TBAMax/WidebandLambda/README.md

# WidebandLambda

LSU4.9 conrtoller hardware based on Arduino Nano and Bosch CJ125 chip.
Has standard 18x2 character LCD display.
Can be used as standalone lambda monitor or as lambda controller for Speeduino.
Originally designed to be used with Speeduino.
