TBAMax/WidebandLambda/KiCad_drawings/TeemoWB1.1/ParandusedLog.odt

- Heaterile flyback diood, kuna võib olla induktiivne koormus. tehtud. Täpsustada:Schottky diood
- Aku pinge lugemise pingejagur Arduino A2 sisendile.Tehtud
- Lisada silukondekas VREFpinile? Kas kasutab seda? Või võtab aluseks toite5V?ei kasuta
- D8 D9 vahetatud. Tehtud
- teha:lisada analog väljund RCfilter pin 9 peale(timer1 väljund)
- Kütte väljund paigutada hoopis D3 pinile. Tehtud.
- ja sealt siis LCD_D6 paigutada A1-le. Tehtud
- edaspidi inglisekeelses failis
