TBAMax/WidebandLambda/KiCad_drawings/TeemoWB1.1/TeemoWB.pdf

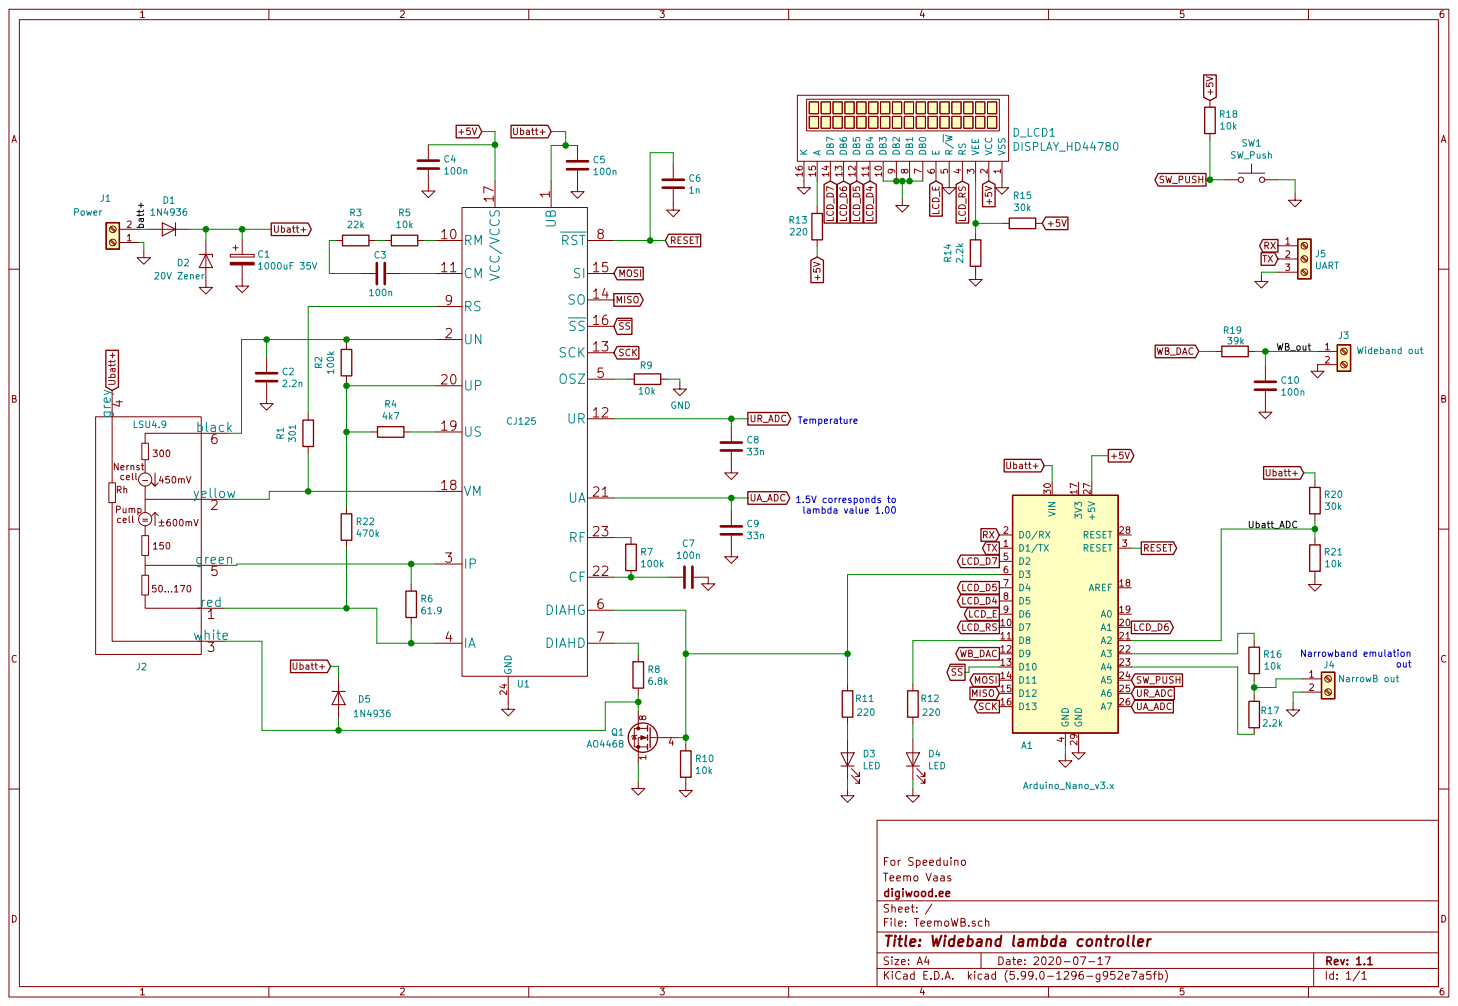
[picture p1: page 1]

Id: 1/1 Title: Wideband lambda controller File: TeemoWB.sch Sheet: / digiwood.ee Teemo Vaas For SpeeduinoR14 2.2k R7
