TBAMax/WidebandLambda/KiCad_drawings/TeemoWB1.1/TeemoWB.kicad_pcb

## KiCad design KiCad_drawings/TeemoWB1.1/TeemoWB.kicad_pcb (2020-08-08)

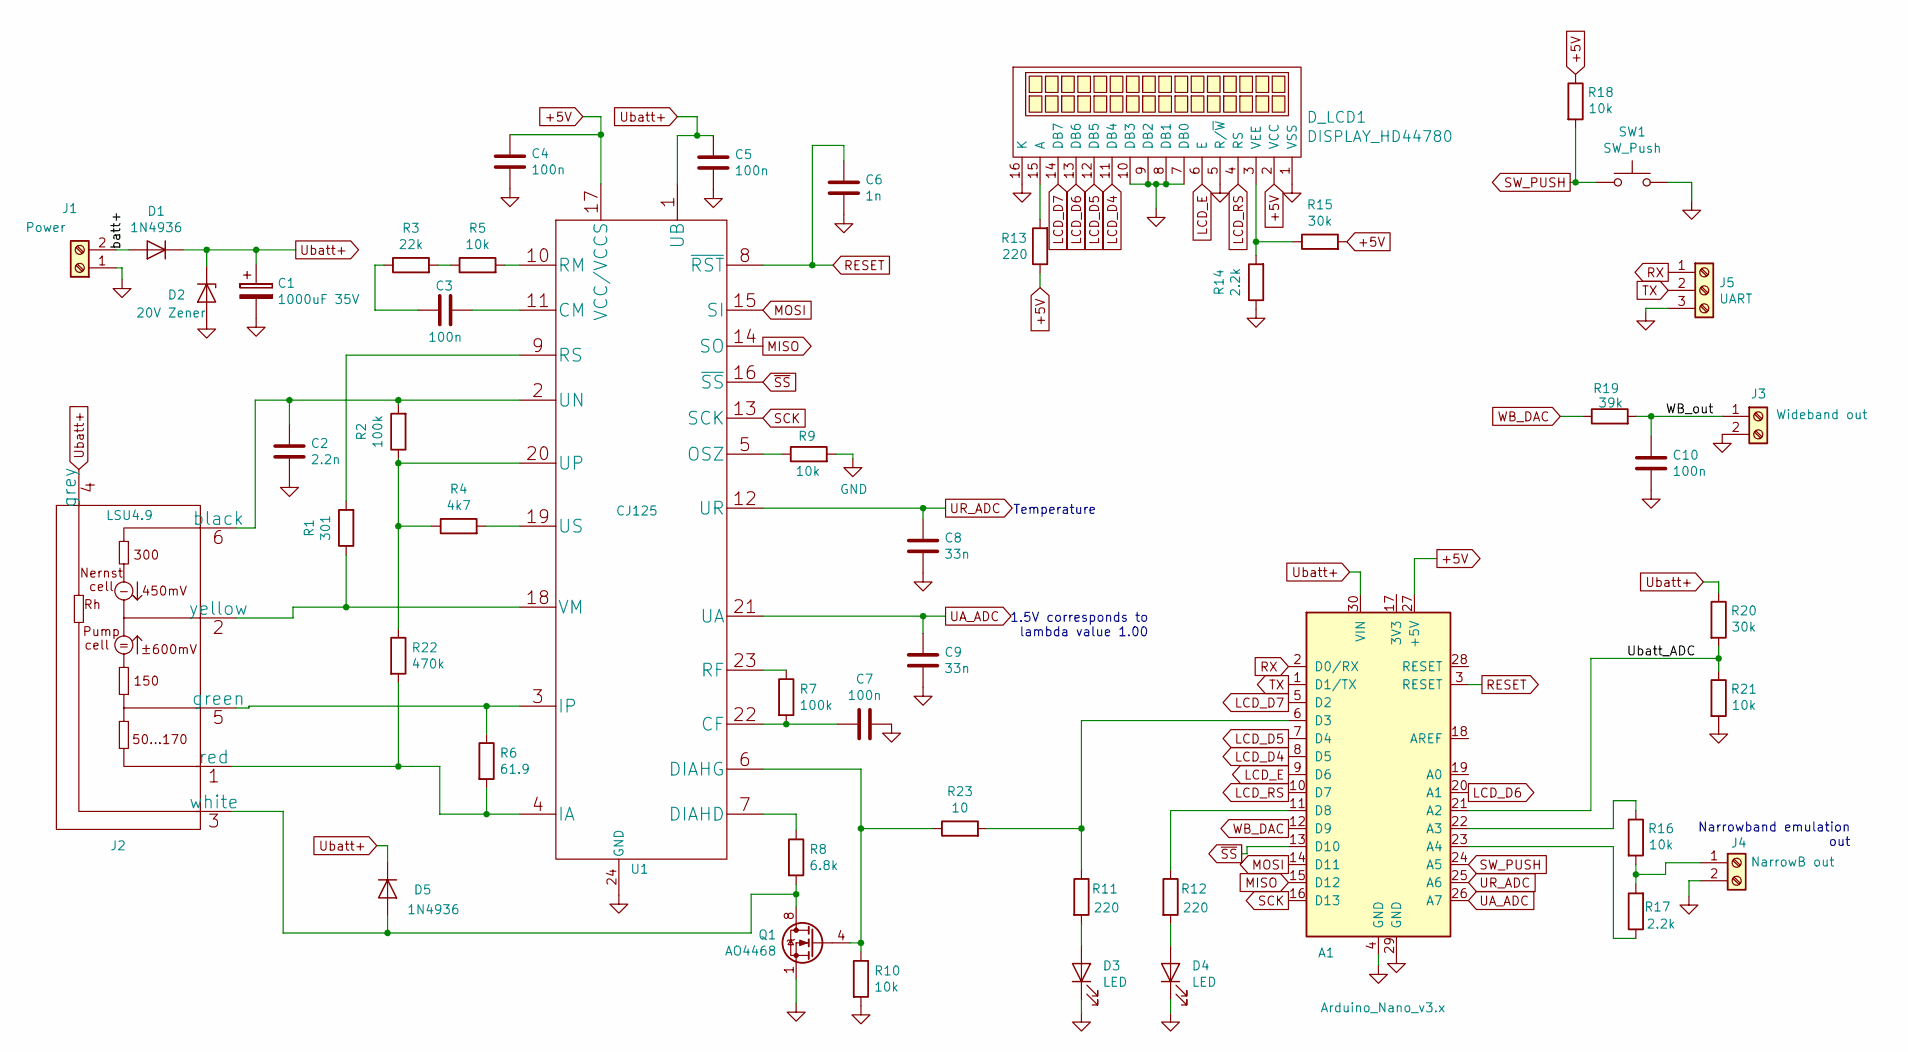
[picture p2: schematic TeemoWB.sch, Wideband lambda controller]

Parts:
A1: Arduino_Nano_v3.x; Arduino_Nano
C1: 1000uF 35V; CP_12.5x25mm_hor
C2: 2.2n; C_1206_3216Metric_Pad1.42x1.75mm_HandSolder
C3, C4, C5, C7, C10: 100n; C_1206_3216Metric_Pad1.42x1.75mm_HandSolder
C6: 1n; C_1206_3216Metric_Pad1.42x1.75mm_HandSolder
C8, C9: 33n; C_1206_3216Metric_Pad1.42x1.75mm_HandSolder
D1, D5: 1N4936; D_DO-41_SOD81_P7.62mm_Horizontal
D2: 20V Zener; D_DO-41_SOD81_P7.62mm_Horizontal
D3, D4: LED; LED_D5.0mm
D_LCD1: DISPLAY_HD44780; lcd_16x2_for_TBMAX_charger
J1: Power; TerminalBlock_Phoenix_MKDS-1,5-2-5.08_1x02_P5.08mm_Horizont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
J2: LSU4.9; TerminalBlock_Phoenix_MKDS-1,5-6-5.08_1x06_P5.08mm_Horizont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
J3: Wideband out; TerminalBlock_Phoenix_MKDS-1,5-2-5.08_1x02_P5.08mm_Horizont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
J4: NarrowB out; TerminalBlock_Phoenix_MKDS-1,5-2-5.08_1x02_P5.08mm_Horizont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
J5: UART; TerminalBlock_Phoenix_MKDS-1,5-3-5.08_1x03_P5.08mm_Horizont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
Q1: AO4468; SOIC-8_3.9x4.9mm_P1.27mm
R1: 301; R_1206_3216Metric
R2, R7: 100k; R_1206_3216Metric
R3: 22k; R_1206_3216Metric
R4: 4k7; R_1206_3216Metric
R5, R9, R10, R16, R18, R21: 10k; R_1206_3216Metric
R6: 61.9; R_1206_3216Metric
R8: 6.8k; R_1206_3216Metric
R11, R12, R13: 220; R_1206_3216Metric
R14, R17: 2.2k; R_1206_3216Metric
R15, R20: 30k; R_1206_3216Metric
R19: 39k; R_1206_3216Metric
R22: 470k; R_1206_3216Metric
R23: 10; R_1206_3216Metric
SW1: SW_Push; SW_PUSH_6mm_H7.3mm
U1: CJ125; SOIC-24W_7.5x15.4mm_P1.27mm

Connections:
+5V: A1.27 (+5V), C4.1, D_LCD1.2 (VCC), R13.1, R15.2, R18.1, U1.17 (VCC/VCCS)
/Ubatt_ADC: A1.21 (A2), R20.2, R21.1
/WB_out: C10.1, J3.1, R19.2
/batt+: D1.2 (A), J1.2
GND: A1.4 (GND), A1.29 (GND), C1.2, C2.2, C4.2, C5.2, C6.2, C7.2, C8.1, C9.1, C10.2, D2.2 (A), D3.1 (K), D4.1 (K), D_LCD1.1 (VSS), D_LCD1.5 (R/~W), D_LCD1.7 (DB0), D_LCD1.8 (DB1), D_LCD1.9 (DB2), D_LCD1.10 (DB3), D_LCD1.16 (K), J1.1, J3.2, J4.2, J5.3, Q1.1 (S), Q1.2 (S), Q1.3 (S), R9.2, R10.2, R14.1, R21.2, SW1.2, U1.24 (GND)
LCD_D4: A1.8 (D5), D_LCD1.11 (DB4)
LCD_D5: A1.7 (D4), D_LCD1.12 (DB5)
LCD_D6: A1.20 (A1), D_LCD1.13 (DB6)
LCD_D7: A1.5 (D2), D_LCD1.14 (DB7)
LCD_E: A1.9 (D6), D_LCD1.6 (E)
LCD_RS: A1.10 (D7), D_LCD1.4 (RS)
MISO: A1.15 (D12), U1.14 (SO)
MOSI: A1.14 (D11), U1.15 (SI)
unnamed: A1.6 (D3), R11.1, R23.2
unnamed: A1.11 (D8), R12.1
unnamed: A1.22 (A3), R16.1
unnamed: A1.23 (A4), R17.1
unnamed: C2.1, J2.6 (black), R2.2, U1.2 (UN)
unnamed: C3.1, R3.1
unnamed: C3.2, U1.11 (CM)
unnamed: C7.1, R7.2, U1.22 (CF)
unnamed: D3.2 (A), R11.2
unnamed: D4.2 (A), R12.2
unnamed: D5.2 (A), J2.3 (white), Q1.5 (D), Q1.6 (D), Q1.7 (D), Q1.8 (D), R8.2
unnamed: D_LCD1.3 (VEE), R14.2, R15.1
unnamed: D_LCD1.15 (A), R13.2
unnamed: J2.1 (red), R6.2, R22.2, U1.4 (IA)
unnamed: J2.2 (yellow), R1.1, U1.18 (VM)
unnamed: J2.5 (green), R6.1, U1.3 (IP)
unnamed: J4.1, R16.2, R17.2
unnamed: Q1.4 (G), R10.1, R23.1, U1.6 (DIAHG)
unnamed: R1.2, U1.9 (RS)
unnamed: R2.1, R4.1, R22.1, U1.20 (UP)
unnamed: R3.2, R5.1
unnamed: R4.2, U1.19 (US)
unnamed: R5.2, U1.10 (RM)
unnamed: R7.1, U1.23 (RF)
unnamed: R8.1, U1.7 (DIAHD)
unnamed: R9.1, U1.5 (OSZ)
RESET: A1.3 (RESET), C6.1, U1.8 (~RST)
RX: A1.2 (D0/RX), J5.1
SCK: A1.16 (D13), U1.13 (SCK)
SW_PUSH: A1.24 (A5), R18.2, SW1.1
TX: A1.1 (D1/TX), J5.2
UA_ADC: A1.26 (A7), C9.2, U1.21 (UA)
UR_ADC: A1.25 (A6), C8.2, U1.12 (UR)
Ubatt+: A1.30 (VIN), C1.1, C5.1, D1.1 (K), D2.1 (K), D5.1 (K), J2.4 (grey), R20.1, U1.1 (UB)
WB_DAC: A1.12 (D9), R19.1
~SS: A1.13 (D10), U1.16 (~SS)

Notes on the sheet:
Temperature
1.5V corresponds to lambda value 1.00
Narrowband emulation out

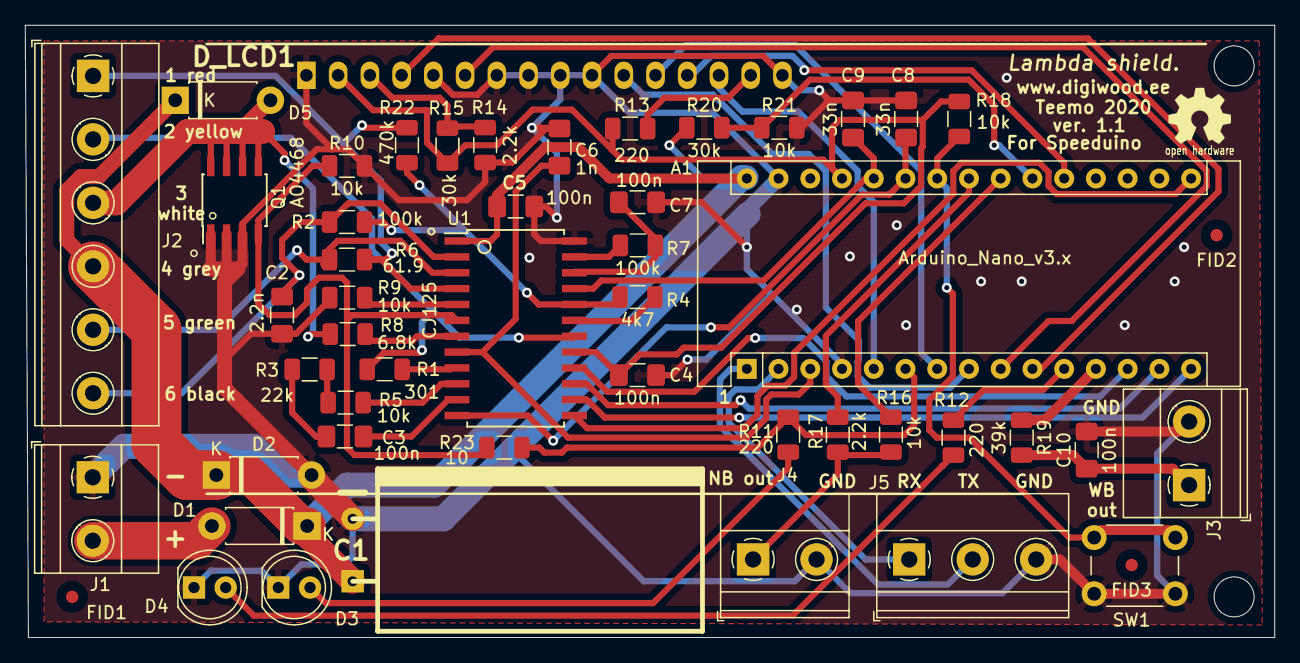
[picture p3: board TeemoWB.kicad_pcb from above]

Board: 2 copper layers, 100.0 x 49.0 mm, 51 parts (0 on the bottom side), 49 nets.

Other parts of the board:
FID1, FID2, FID3: Fiducial_1mm_Dia_2.54mm_Outer_CopperTop
