TBAMax/WidebandLambda/KiCad_drawings/TeemoWB1.1/ChangeLog.odt

- Add Flyback diode to the heater circuit. Done. Maybe further: use Schottky diode
- Battery voltage reading circuit to Arduino pin A2.Done
- Change led from pin D9toD8. Done
- Analog output with RC filter on pin 9 (timer1 output). Done
- Heater output to D3 pin (timer2 PWM). Done.
- move LCD_D6 to pin A1-le. Done
- Added R22
