TBAMax/WidebandLambda/(commit log)

2020-08-08 Add schematics and board design files
    [TeemoWB-B_Cu.gbl, TeemoWB-B_Mask.gbs, TeemoWB-B_Paste.gbp, TeemoWB-B_SilkS.gbo, TeemoWB-Edge_Cuts.gm1, TeemoWB-F_Cu.gtl, TeemoWB-F_Mask.gts, TeemoWB-F_Paste.gtp]
2020-08-08 Add Arduino source code
    [UaToLambda.ods, UrToTemp.ods]
